openadsb/openadsb/references/miniADSB 1090 MHz Receiver_files/index_data/pdf-symbol.jpg

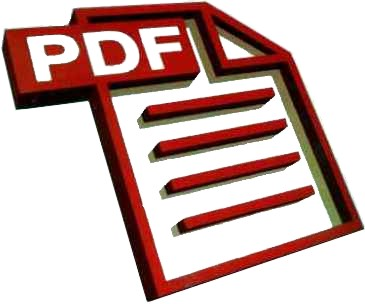
references/miniADSB 1090 MHz Receiver_files/index_data/pdf-symbol.jpg
