openadsb/openadsb/hardware/pcb/Project Outputs for openadsb_rev_a/Bill of Materials-openadsb_rev_a.xls

Quantity | NOLOAD | Designator | Comment | Description | Footprint | Manufacturer | PartNumber
6 |  | C1, C5, C11, C13, C15, C34 | 100p | Capacitor | 0402 | TDK | CGJ2B2C0G1H101J
1 |  | C2 | 12p | Capacitor | 0402 | Taiyo Uden | UMK105CG120JV-F
1 |  | C3 | 4.7p | Capacitor | 0402 | Xicon | 140-CC505N4.7C-RC
4 |  | C4, C9, C16, C18 | 39p | Capacitor | 0402 | TDK | CGA2B2C0G1H390J
2 |  | C6, C17 | 22n | Capacitor | 0402 | TDK | CGJ2B2X7R1E223K
1 |  | C7 | 56p | Capacitor | 0402 | Kemet | C0402C560J5GACTU
1 |  | C8 | 10p | Capacitor | 0402 | Kemet (http://www.mouser.com/kemet/) | C0402C100J5GALTU (https://www.mouser.com/Search/ProductDetail.aspx)
9 |  | C10, C12, C14, C22, C24, C26, C27, C30, C36 | 100n | Capacitor | 0402 | TDK | CGA2B1X7R1C104K
2 |  | C19, C20 | 2.7p | Capacitor | 0402 | Murata | GRM1556T1H2R7CD01D
5 |  | C23, C29, C31, C32, C35 | 2.2 uF | Capacitor | 1608[0603] | TDK | C1608X5R1V225K
2 |  | C25, C28 | 7 p | Capacitor | 0402
1 |  | C33 | 4.7 uF | Capacitor | 1608[0603] | Murata | GRM188R60J475ME19D
1 |  | D1 | PACDN004-D | ESD protection | SOT-143-RC4_L | On Semi | PACDN004-D
1 |  | D2 | GREEN | LED | LED0603
1 |  | D3 | RED | LED | LED0603
1 |  | J1 | SMA end-launch | SMB Straight Connector | SMA_ENDLAUNCH | Amphenol Connex | 132289
1 | NOLOAD | J2 | Header 3X2 | Header, 3-Pin, Dual row | HDR2X3
2 |  | L1, L4 | 82 nH | Inductor | 0402 | TOKO | TKS2388CT
1 |  | L5 | 8.2 nH | Inductor | 0402 | TDK | MLK1005S8N2D
5 |  | L2, L3, L6, L7, L8 | Ferrite bead >220ohms @ 100MHz | Magnetic-Core Inductor | 0402
1 |  | P1 | 1470695-4 | USB 1.1, Right Angle, SMT, A Type, Plug, 4 Position, Black | 1470695A | Molex | 48037-1000
2 |  | R1, R16 | 10K | Resistor | 0402 | Xicon | 304-10K-RC
2 |  | R2, R4 | 6.98K | Resistor | 0402 | Panasonic | ERJ-2RKF6981X
1 |  | R3 | 7.87K | Resistor | 0402 | Xicon | 304-7.87K-RC
2 |  | R5, R10 | 2.26K | Resistor | 0402 | Panasonic | ERJ-2RKF2261X
1 |  | R6 | 5.6K | Resistor | 0402 | Xicon | 304-5.62K-RC
3 |  | R7, R8, R13 | 4.7k | Resistor | 0402 | Bourns | CR0402-FX-4701GLF
3 |  | R9, R12, R20 | 47K | Resistor | 0402 | Bourns | CR0402-FX-4702GLF
1 |  | R11 | 1.96K | Resistor | 0402 | Vishay-Dale | CRCW04021K96FKED
2 |  | R14, R15 | 10 | Resistor | 0402 | Xicon | 304-10-RC
1 |  | R17 | 470 | Resistor | 0402
1 |  | R18 | 680 | Resistor | 0402 | Panasonic | ERJ-2RKF6800X
1 |  | R19 | 100K | Resistor | 0402
2 |  | R21, R22 | 27 | Resistor | 0402 | Vishay-Dale | CRCW040227R0FKED
1 |  | U1 | SPF-5122Z |  | DFN8_2x2mm | Sirenza | SPF-5122Z
1 |  | U2 | LT1801IDD |  | DFN8_3x3mm | Linear Tech | LT1801IDD
1 |  | U3 | AD8313 | AD8313 Logarithmic Amp | MSOP-MS8_N
1 |  | U4 | SGL-0622Z |  | DFN8_2x2mm | RFMD | SGL-0622Z
1 |  | U5 | SST25VF010A |  | WSON-8 | SST | SST25VF010A
1 |  | U6 | TPS79942DDCR |  | SOT23-5AN | Texas Instruments | TPS79942DDCR
1 |  | U7 | ATxmega16A4U-MH |  | QFN50P700X700-44W3N | Atmel | ATxmega16A4U-MH
1 |  | U8 | TPS79933DDCR |  | SOT23-5AN | Texas Instruments | TPS79933DDCR
1 |  | X1 | STA1090EC |  | STA1090EC |  | STA1090EC
1 |  | X2 | STA0232A |  |  |  | STA0232A
1 |  | Y1 | 8.000 MHz |  | ABM3C | Abracon | ABM3B-8.000MHZ-B2-T
case |  |  |  |  |  | New Age Enclosures (http://www.mouser.com/newageenclosures/) | P3A-260906U (https://www.mouser.com/Search/ProductDetail.aspx)
Light pipes |  |  |  |  |  | Bivar | PLP2-215
