openadsb/openadsb/hardware/pcb/Project Outputs for openadsb_rev_a/Schematic Prints.PDF

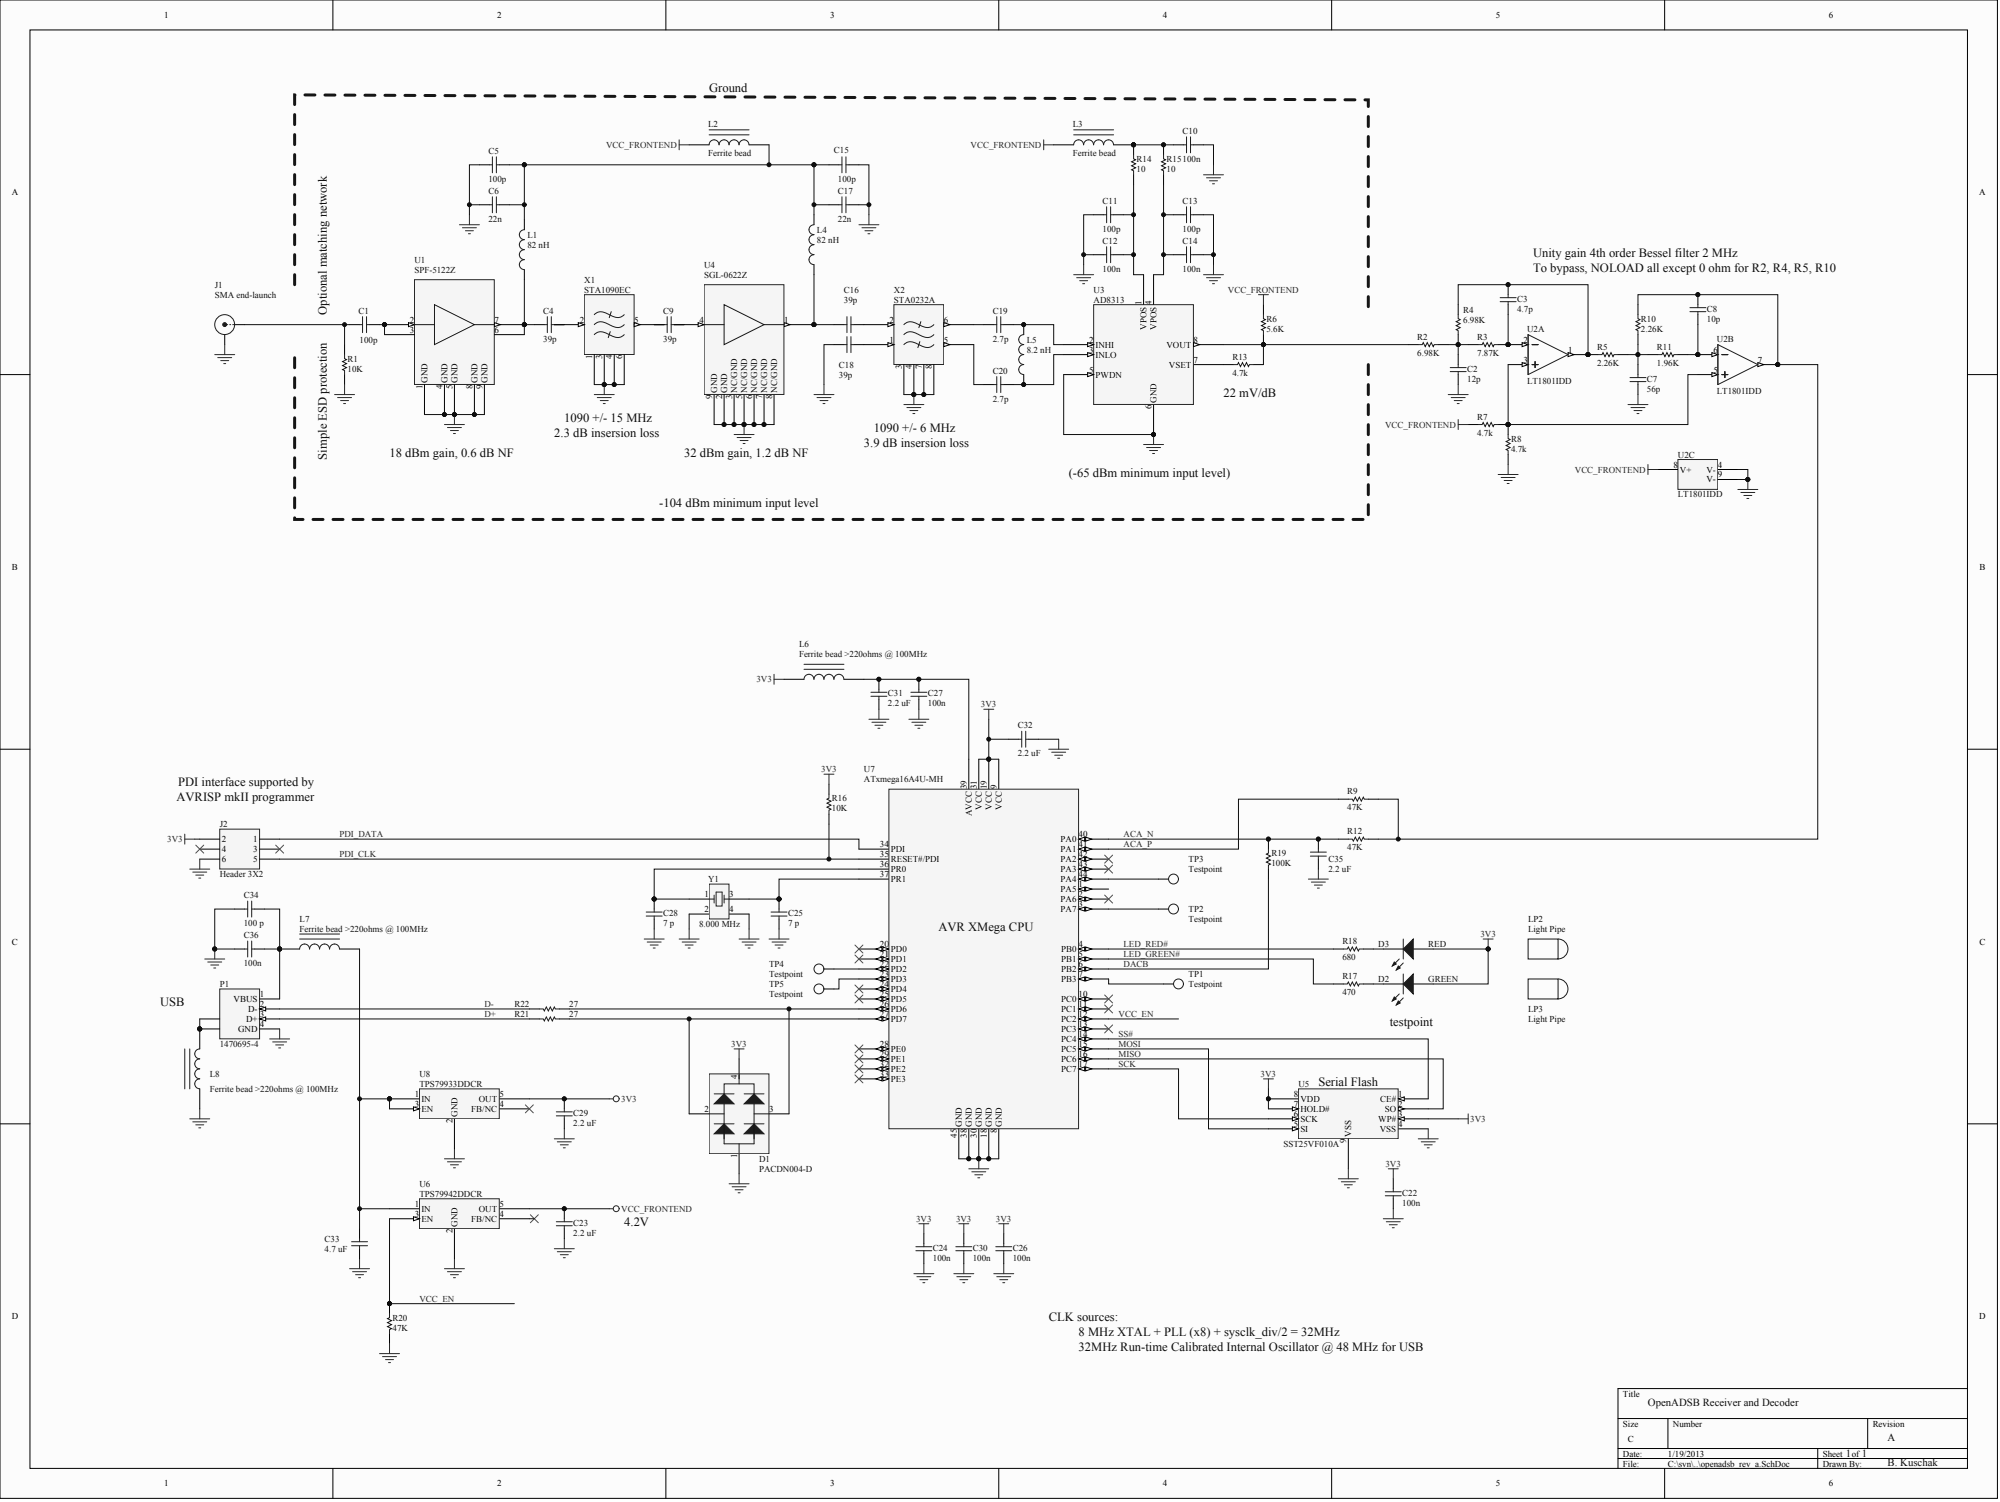
[picture p5: page 1]

Unity gain 4th order Bessel filter 2 MHz
To bypass, NOLOAD all except 0 ohm for R2, R4, R5, R10

18 dBm gain, 0.6 dB NF

32 dBm gain, 1.2 dB NF

(-65 dBm minimum input level)

-104 dBm minimum input level

PDI interface supported by
AVRISP mkII programmer

ACA_P

PDI_CLK

TP2 Testpoint LED_RED# LED_GREEN#

DACB

MOSI
MISO
SCK | Serial Flash U5

VSS 4 SI 5 SCK 6 HOLD# 7 VDD 8

CLK sources:
8 MHz XTAL + PLL (x8) + sysclk_div/2 = 32MHz
32MHz Run-time Calibrated Internal Oscillator @ 48 MHz for USB

Title
OpenADSB Receiver and Decoder
