openadsb/openadsb/hardware/pcb/Project Outputs for openadsb_rev_a/Assembly Drawing.PDF

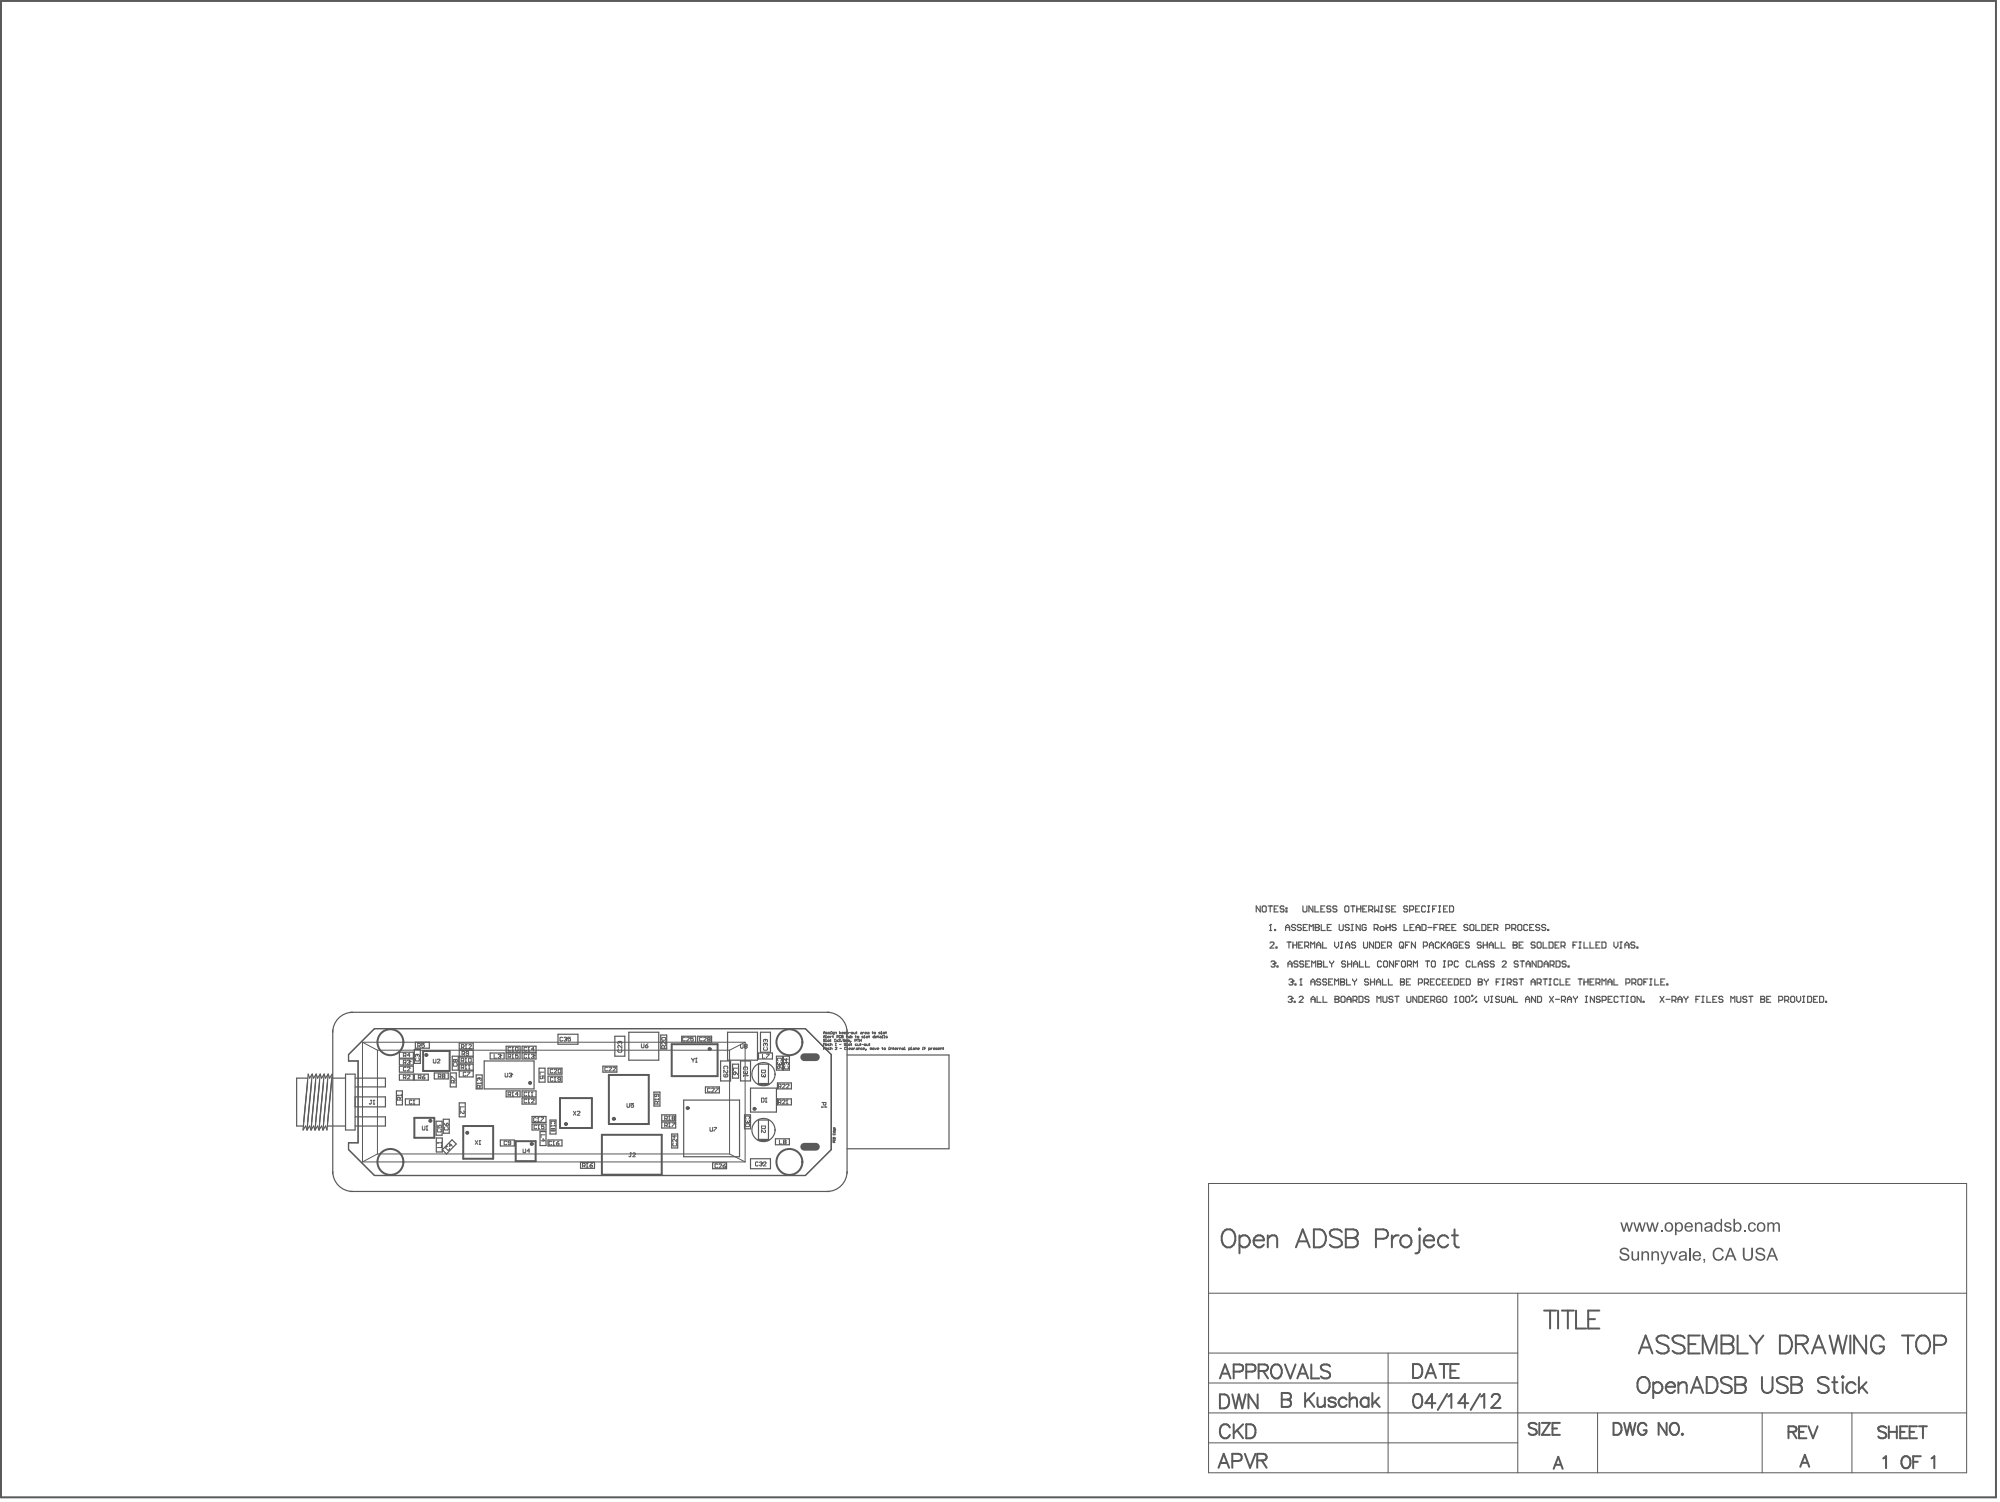
[picture p6: page 1]
