openadsb/openadsb/hardware/pcb/Project Outputs for openadsb_rev_a/Electrical Fab Drawing.PDF

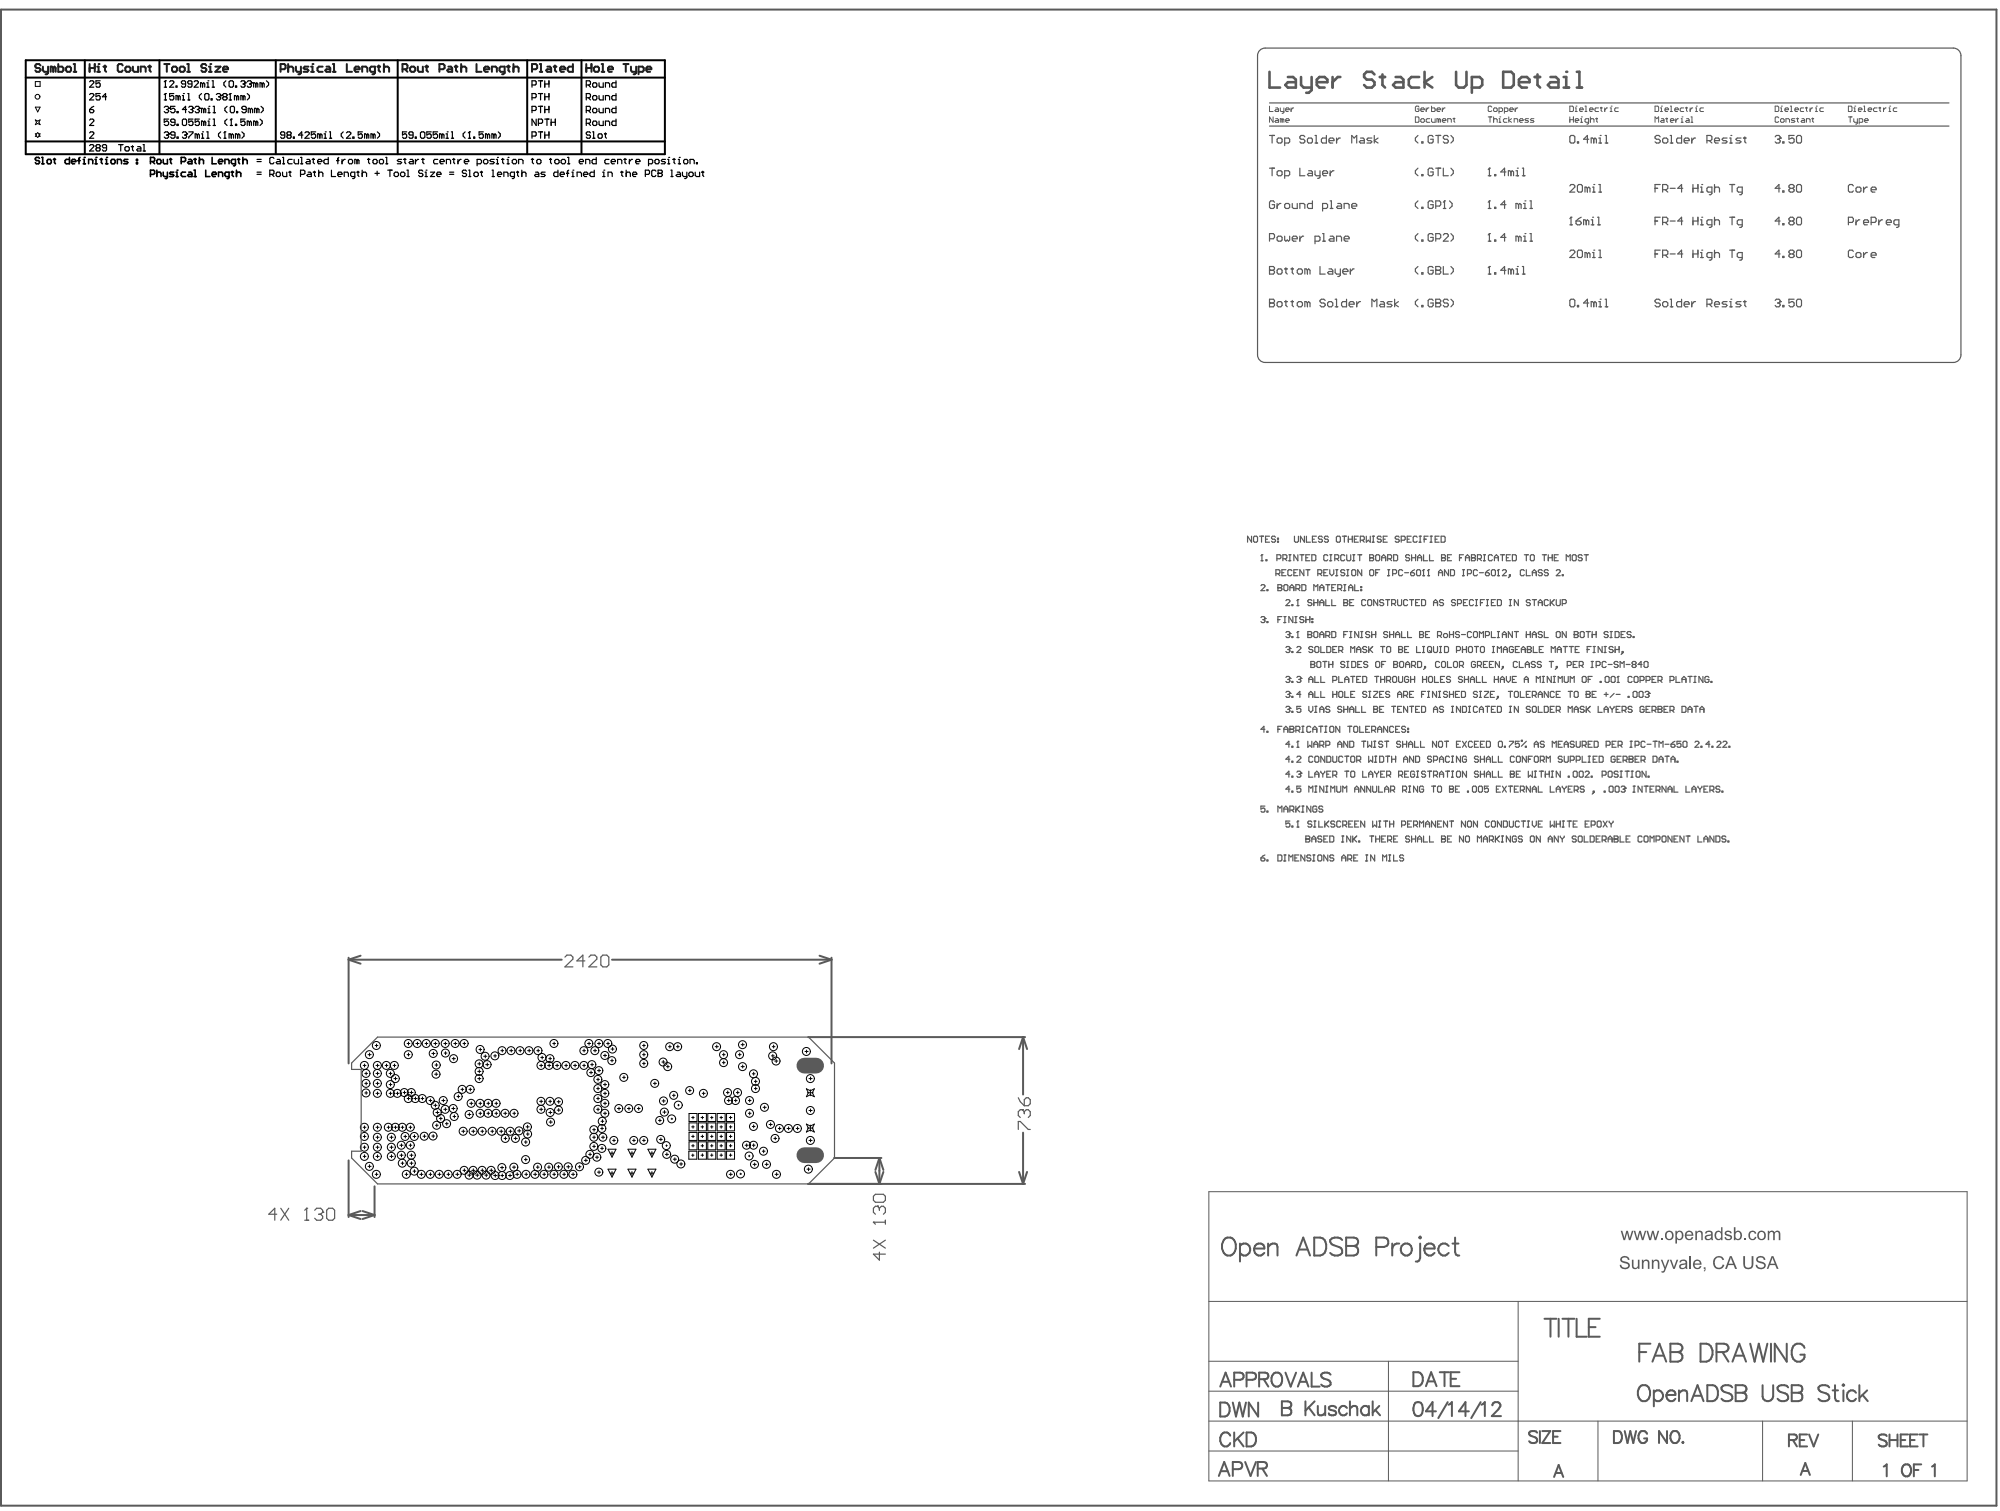
[picture p7: page 1]
