openadsb/openadsb/(list of files, drawings)

Other design files:
hardware/pcb/openadsb_rev_a.PcbDoc
hardware/pcb/openadsb_rev_a.PcbLib
hardware/pcb/openadsb_rev_a.PrjPcb
hardware/pcb/openadsb_rev_a.SchDoc
hardware/pcb/openadsb_rev_a.SCHLIB
