openadsb/openadsb/firmware/io.h

/* Copyright (c) 2002,2003,2005,2006,2007 Marek Michalkiewicz, Joerg Wunsch
   Copyright (c) 2007 Eric B. Weddington
   All rights reserved.

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
   * Neither the name of the copyright holders nor the names of
     contributors may be used to endorse or promote products derived
     from this software without specific prior written permission.

  THIS SOFTWARE IS PROVIDED BY THE COPYRIGHT HOLDERS AND CONTRIBUTORS "AS IS"
  AND ANY EXPRESS OR IMPLIED WARRANTIES, INCLUDING, BUT NOT LIMITED TO, THE
  IMPLIED WARRANTIES OF MERCHANTABILITY AND FITNESS FOR A PARTICULAR PURPOSE
  ARE DISCLAIMED. IN NO EVENT SHALL THE COPYRIGHT OWNER OR CONTRIBUTORS BE
  LIABLE FOR ANY DIRECT, INDIRECT, INCIDENTAL, SPECIAL, EXEMPLARY, OR
  CONSEQUENTIAL DAMAGES (INCLUDING, BUT NOT LIMITED TO, PROCUREMENT OF
  SUBSTITUTE GOODS OR SERVICES; LOSS OF USE, DATA, OR PROFITS; OR BUSINESS
  INTERRUPTION) HOWEVER CAUSED AND ON ANY THEORY OF LIABILITY, WHETHER IN
  CONTRACT, STRICT LIABILITY, OR TORT (INCLUDING NEGLIGENCE OR OTHERWISE)
  ARISING IN ANY WAY OUT OF THE USE OF THIS SOFTWARE, EVEN IF ADVISED OF THE
  POSSIBILITY OF SUCH DAMAGE. */

/* $Id: io.h,v 1.52.2.28 2009/12/20 17:02:53 arcanum Exp $ */

/** \file */
/** \defgroup avr_io <avr/io.h>: AVR device-specific IO definitions
    \code #include <avr/io.h> \endcode

    This header file includes the apropriate IO definitions for the
    device that has been specified by the <tt>-mmcu=</tt> compiler
    command-line switch.  This is done by diverting to the appropriate
    file <tt>&lt;avr/io</tt><em>XXXX</em><tt>.h&gt;</tt> which should
    never be included directly.  Some register names common to all
    AVR devices are defined directly within <tt>&lt;avr/common.h&gt;</tt>,
    which is included in <tt>&lt;avr/io.h&gt;</tt>,
    but most of the details come from the respective include file.

    Note that this file always includes the following files:
    \code 
    #include <avr/sfr_defs.h>
    #include <avr/portpins.h>
    #include <avr/common.h>
    #include <avr/version.h>
    \endcode
    See \ref avr_sfr for more details about that header file.

    Included are definitions of the IO register set and their
    respective bit values as specified in the Atmel documentation.
    Note that inconsistencies in naming conventions,
    so even identical functions sometimes get different names on
    different devices.

    Also included are the specific names useable for interrupt
    function definitions as documented
    \ref avr_signames "here".

    Finally, the following macros are defined:

    - \b RAMEND
    <br>
    The last on-chip RAM address.
    <br>
    - \b XRAMEND
    <br>
    The last possible RAM location that is addressable. This is equal to 
    RAMEND for devices that do not allow for external RAM. For devices 
    that allow external RAM, this will be larger than RAMEND.
    <br>
    - \b E2END
    <br>
    The last EEPROM address.
    <br>
    - \b FLASHEND
    <br>
    The last byte address in the Flash program space.
    <br>
    - \b SPM_PAGESIZE
    <br>
    For devices with bootloader support, the flash pagesize
    (in bytes) to be used for the \c SPM instruction. 
    - \b E2PAGESIZE
    <br>
    The size of the EEPROM page.
    
*/

#ifndef _AVR_IO_H_
#define _AVR_IO_H_

#include <avr/sfr_defs.h>

#include "iox16a4u.h"

#include <avr/portpins.h>

#include <avr/common.h>

#include <avr/version.h>

/* Include fuse.h after individual IO header files. */
#include <avr/fuse.h>

/* Include lock.h after individual IO header files. */
#include <avr/lock.h>

#endif /* _AVR_IO_H_ */
