openadsb/openadsb/firmware/bootloader/bootloader.c

// USB Bootloader for Xmega AU
// http://nonolithlabs.com
// (C) 2011 Kevin Mehall (Nonolith Labs) <km@kevinmehall.net>
//
// Licensed under the terms of the GNU GPLv3+

#include "bootloader.h"
#include "sp_driver.h"

//
// Nonolith bootloader protocol
//

#define REQ_INFO		0xB0
// Returns a BootloaderInfo with info about the device
typedef struct{
	uint8_t magic[4]; // String 0x90 0x90 0xBB 0x01
	uint8_t version;
	uint8_t DEVID0;   // Device/Revision ID from MCU. See XMEGA AU Manual p46
	uint8_t DEVID1;
	uint8_t DEVID2;
	uint8_t REVID;
	uint16_t page_size;  // Page size in bytes
	uint32_t app_section_end; // Byte address of end of flash. Add one for flash size
	uint32_t entry_jmp_pointer; // App code can jump to this pointer to enter the bootloader
	char hw_product[16];
	char hw_version[16];
} BootloaderInfo;

#define REQ_ERASE		0xB1
// Erases the application section

#define REQ_START_WRITE 0xB2
// Sets the write pointer to the page address passed in wIndex.
// Data written to bulk endpoint 1 will be written at this address, and the
// address will be incremented automatically. The transfer is complete when a
// packet of less than 64 bytes is written.

#define REQ_CRC_APP		0xB3
// Return a CRC of the application section

#define REQ_CRC_BOOT	0xB4
// Return a CRC of the boot section

#define REQ_RESET	0xBF
// After acknowledging this request, the bootloader disables USB and resets
// the microcontroller

//
// End protocol definition
//


// Override these with parameters in the makefile
#ifndef HW_PRODUCT
#error "HW_PRODUCT not specified"
#endif

#ifndef HW_VERSION
#error "HW_VERSION not specified"
#endif

#ifndef CHECK_PORT
#define CHECK_PORT PORTD
#endif

#ifndef CHECK_PIN
#define CHECK_PIN 3
#endif

#ifndef LED_PORT
#define LED_PORT PORTB	
#endif

// Red LED
#ifndef LED_PIN
#define LED_PIN 0
#endif

#ifndef VCC_EN_PORT
#define VCC_EN_PORT PORTC
#endif

#ifndef VCC_EN_PIN
#define VCC_EN_PIN 2
#endif

#define CONCAT_HIDDEN(a, b, c) a##b##c
#define PINCTRL(n) CONCAT_HIDDEN(PIN, n, CTRL)

#define xstringify(s) stringify(s)
#define stringify(s) #s

/// Flash page number where received data will be written
uint16_t page;

/// Byte offset into flash page of next data to be received
uint16_t pageOffs;

/// Buffer of incoming flash page
uint8_t pageBuf[APP_SECTION_PAGE_SIZE];

/// Size of IN endpoint receiving flash data
#define EP1_SIZE 64

void pollEndpoint(void);

/// Configure the device for bootloader mode and loop responding to bootloader commands
void runBootloader(void){
	// Turn on LED
	LED_PORT.DIRSET = (1<<LED_PIN);
	LED_PORT.OUTCLR = (1<<LED_PIN);	// active low

	// power down RF section.  
	VCC_EN_PORT.DIRSET |= (1<<VCC_EN_PIN);	
	VCC_EN_PORT.OUTCLR = (1<<VCC_EN_PIN);	
	
	USB_ConfigureClock();
	
	_delay_us(100000); // 0.1s
		
	USB_Init();
	USB_ep_out_init(1, USB_EP_TYPE_BULK_gc, EP1_SIZE);
	sei();
	
	uint16_t i=0;
	
	while (1){
		USB_Task();
		pollEndpoint();
		
		if (++i == 0) LED_PORT.OUTTGL = (1 << LED_PIN);
	}
}

#define BOOTLOADER_MAGIC 0x9090BB01
uint32_t bootloaderflag __attribute__ ((section (".noinit"))); 

void reset_into_bootloader(){
	PMIC.CTRL = 0;
	bootloaderflag = BOOTLOADER_MAGIC;
	CCP = CCP_IOREG_gc;
	RST.CTRL = RST_SWRST_bm;
	while(1);
}

/// Jump target at known address to call from application code to switch to bootloader
extern void enterBootloader(void) __attribute__((used, naked, section(".boot-entry")));
void enterBootloader(void){
	reset_into_bootloader();
}

int main(void){
	// Pull up pin to test if it's being pulled low
	CHECK_PORT.DIR = 0;
	CHECK_PORT.PINCTRL(CHECK_PIN) = PORT_OPC_PULLUP_gc;
	
	_delay_us(100);

	if (!(CHECK_PORT.IN & (1<<CHECK_PIN)) // If the specified pin is pulled LOW
	|| pgm_read_word(0) == 0xFFFF // Get the value of the reset vector. If it's unprogrammed, we know
	                               // there's nothing useful in app flash
	|| (RST.STATUS & RST_SRF_bm && bootloaderflag == BOOTLOADER_MAGIC) // If the app code reset into the bootloader
	){
		bootloaderflag = 0;
		runBootloader();
	}
	
	// Otherwise, clean up and jump to the app
	RST.STATUS = RST_SRF_bm;
	bootloaderflag = 0;
	//CHECK_PORT.PIN0CTRL = 0;
	CHECK_PORT.PINCTRL(CHECK_PIN) = 0;
	LED_PORT.PIN0CTRL = 0;
	EIND = 0x00;
	void (*reset_vect)( void ) = 0x000000;
    reset_vect();
}


/// Pack the ep0 input buffer with a response to REQ_INFO
void fillInfoStruct(void){
	BootloaderInfo *i=(BootloaderInfo*)ep0_buf_in;
	i->magic[0] = 0x90;
	i->magic[1] = 0x90;
	i->magic[2] = 0xBB;
	i->magic[3] = 0x01;
	i->version = 1;
	i->DEVID0 = MCU.DEVID0;
	i->DEVID1 = MCU.DEVID1;
	i->DEVID2 = MCU.DEVID2;
	i->REVID = MCU.REVID;
	i->page_size = APP_SECTION_PAGE_SIZE;
	i->app_section_end = APP_SECTION_END;
	i->entry_jmp_pointer = (uint32_t) (unsigned) &enterBootloader;
	strncpy(i->hw_product, xstringify(HW_PRODUCT), 16);
	strncpy(i->hw_version, xstringify(HW_VERSION), 16);
}


/// Handle USB control requests
bool EVENT_USB_Device_ControlRequest(USB_Request_Header_t* req){
	if ((req->bmRequestType & CONTROL_REQTYPE_TYPE) == REQTYPE_VENDOR){
		switch (req->bRequest){
			case REQ_INFO:
				fillInfoStruct();
				USB_ep0_send(sizeof(BootloaderInfo));
				return true;
			case REQ_ERASE:
				SP_EraseApplicationSection();
				USB_ep0_send(0);
				return true;
			case REQ_START_WRITE:
				page = req->wIndex;
				pageOffs = 0;
				USB_ep_out_start(1, pageBuf);
				USB_ep0_send(0);
				return true;
			case REQ_CRC_APP:
				*(uint32_t*)ep0_buf_in = SP_ApplicationCRC();
				USB_ep0_send(sizeof(uint32_t));
				return true;
			case REQ_CRC_BOOT:
				*(uint32_t*)ep0_buf_in = SP_BootCRC();
				USB_ep0_send(sizeof(uint32_t));
				return true;
			case REQ_RESET:
				USB_ep0_send(0);
				USB_ep0_wait_for_complete();
				_delay_us(10000);
				USB_Detach();
				bootloaderflag = 0;
				
				cli();
				_delay_us(100000); // 0.1s
				CCP = CCP_IOREG_gc;
				RST.CTRL = RST_SWRST_bm;
				while(1){};
				
				return true;
		}
	}
	
	return false;
}


void pollEndpoint(void){
	if (USB_ep_out_received(1)){		
		
		pageOffs += EP1_SIZE;

		if (pageOffs == APP_SECTION_PAGE_SIZE){
			// Write a page to flash
			SP_LoadFlashPage(pageBuf);
			NVM.CMD = NVM_CMD_NO_OPERATION_gc;
			SP_WriteApplicationPage(page*APP_SECTION_PAGE_SIZE);
			SP_WaitForSPM();
			NVM.CMD = NVM_CMD_NO_OPERATION_gc;
			
			page++;
			pageOffs = 0;
		}

		if (page * APP_SECTION_PAGE_SIZE < APP_SECTION_END){
			// If there's remaining room in flash, configure the endpoint to accept more data
			USB_ep_out_start(1, &pageBuf[pageOffs]);
		}
	}
}
