openadsb/openadsb/(commit log)

2013-01-20 Added hardware source files and CAM files
    [Bill of Materials-openadsb_rev_a.xls, Bill of Materials-openadsb_rev_a_mod.xlsx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]
2013-01-20 Remove old BOM file.
    [Bill of Materials-openadsb_rev_a_mod.xlsx]
2013-01-20 Update BOM
    [Bill of Materials-openadsb_rev_a.xls]
2013-01-21 Various improvements: - mouseover map now highlights table entry and highlights track in map with arrow - updateAircraftPosition() implemented as separate SIGNAL, so map isn't redrawing same position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
2013-01-21 Fix a crash due to printf
    [decoder.py]
2013-01-23 Fix bug for non-existant file
    [flightradar24.py]
2013-02-02 Add a dedicated USB service thread to read the USB port as fast as possible to avoid stalling the receiver.
    [reader.py]
2013-02-02 Use flightradar24 database for flight lookups. Remove some debug printfs. Fix handling of on-ground packets. Add some missing countries to list.
    [airport-codes.csv]
2013-02-02 Remove debug prints
2013-02-24 Fix bug in settings save/restore
    [gmaps.py]
2013-07-19 Fixes for ground position and velocity. Added some reference docs.
    [aircraft.py, decoder.py, gmaps.py, tablewidget.py]
2013-08-18 lookup airlines by flight id
    [airline-codes.csv]
2013-08-19 Added some missing codes.
    [airline-codes.csv]
2013-08-31 Fixed FR24 flight details lookup. Added a few more to airline database. Added packet rate statistic.
    [airline-codes.csv]
2014-03-12 Work in progress. Decoder cleanup - refactor common code.
    [airline-codes.csv]
2014-03-14 Fixed problem with spurious CRC errors on DF11, DF17, DF18. Added decoding and tracking of IIC interrogator identifier codes. Added some more reference material.
    [aircraft.py, decoder.py, main.py, reader.py, tablewidget.py]
2014-03-14 Fix error in TIS after update for IIC.
    [decoder.py]
2014-03-15 Fix minor bugs. Add barometric pressure indication.
    [decoder.py, main.py]
